jjmz/ula-vhdl/pics/Readme.md

Some pics :

The test/dev platform :

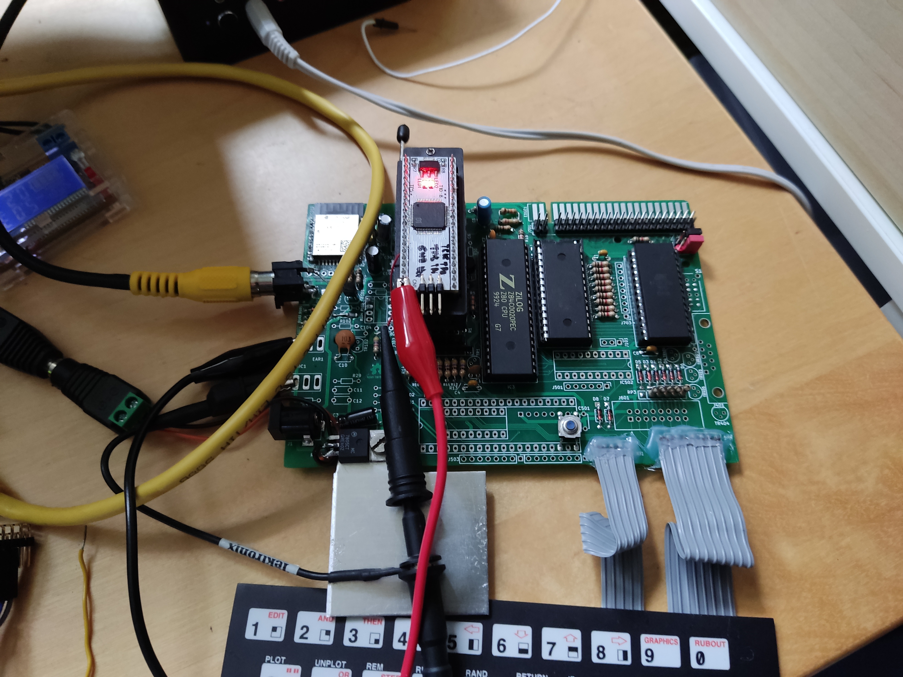
[picture p5: pics/IMG_20231112_103053.jpg]
devboard


Memory mapping with A13 connected :

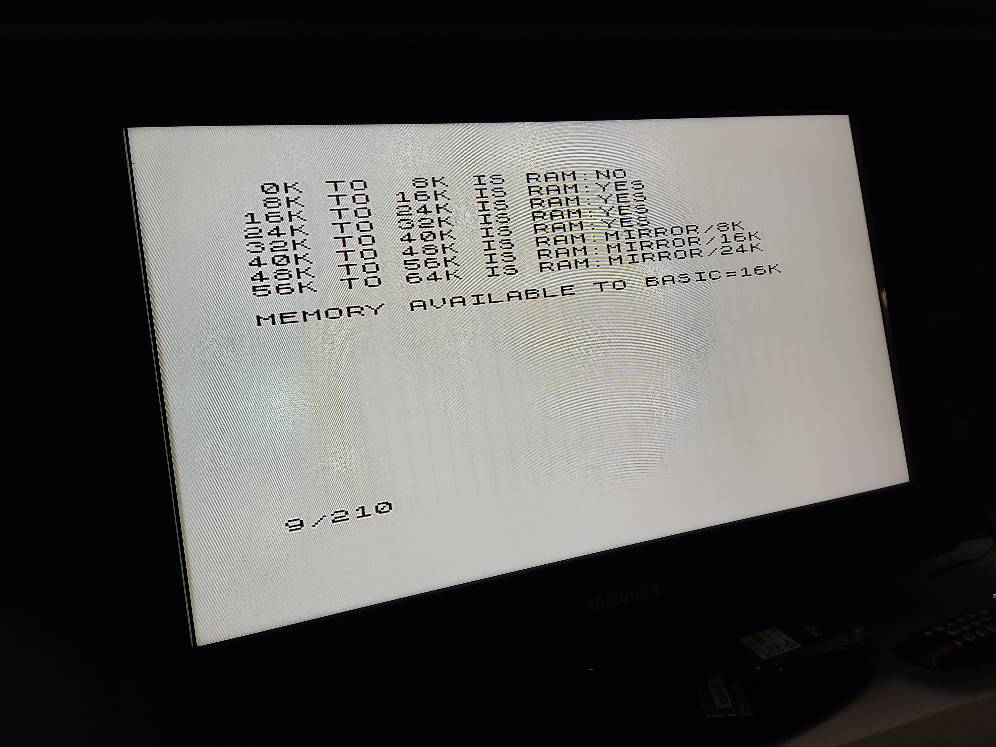
[picture p6: pics/IMG_20231107_162408.jpg]
memory1

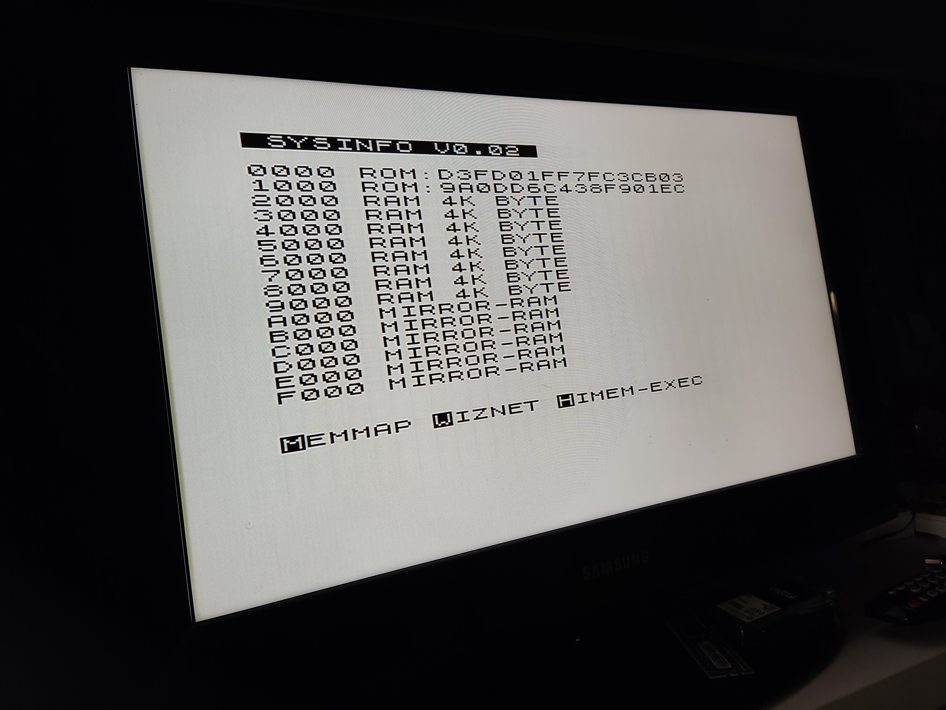
[picture p7: pics/IMG_20231107_162558.jpg]
memory2


Demo : 25thanni

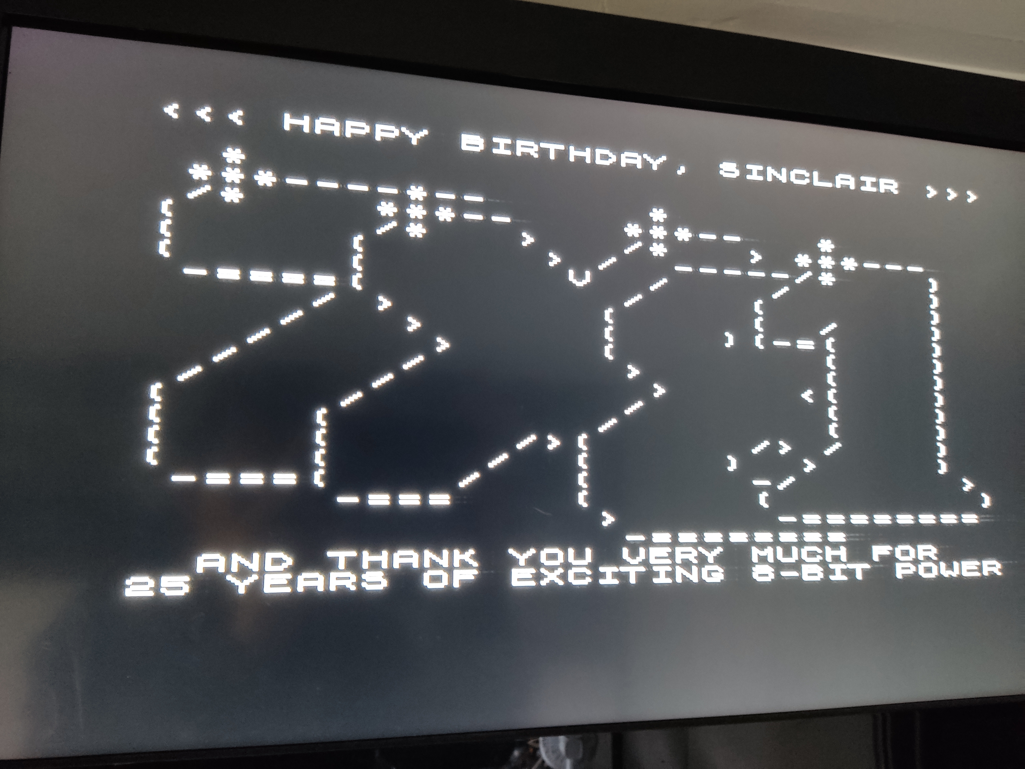
[picture p8: pics/IMG_20231112_103525.jpg]
demo1

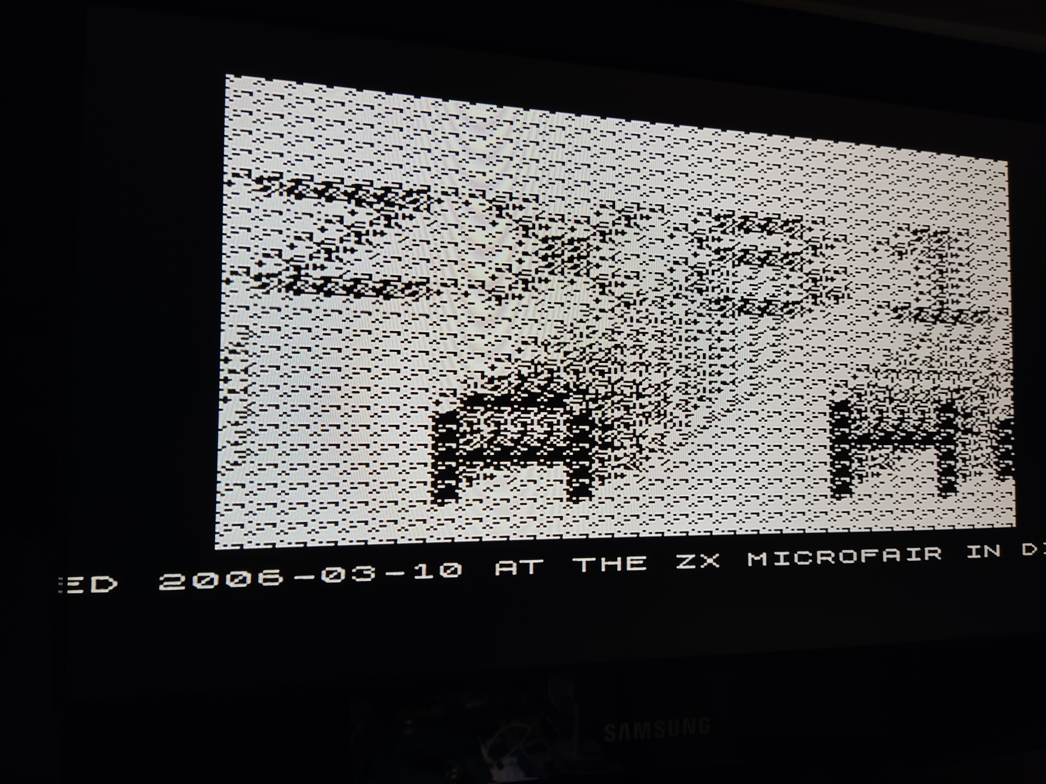
[picture p9: pics/IMG_20231112_103541.jpg]
demo2

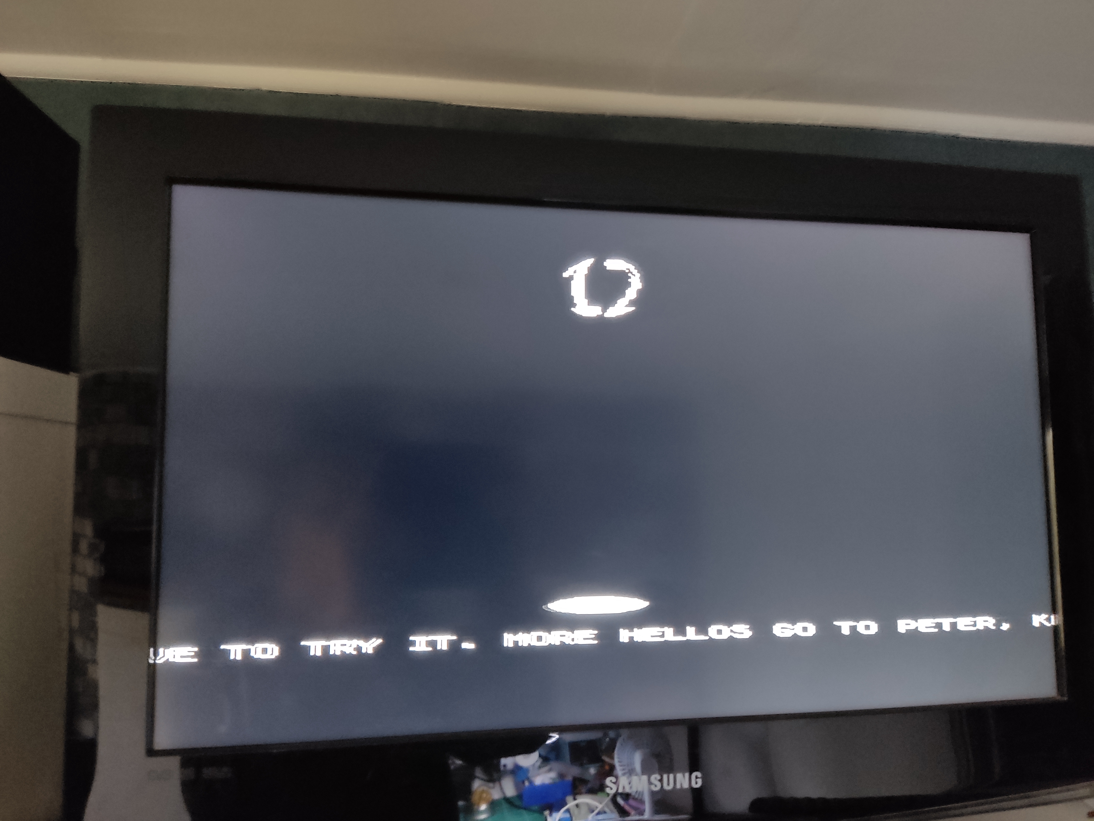
[picture p10: pics/IMG_20231112_103648.jpg]
demo3

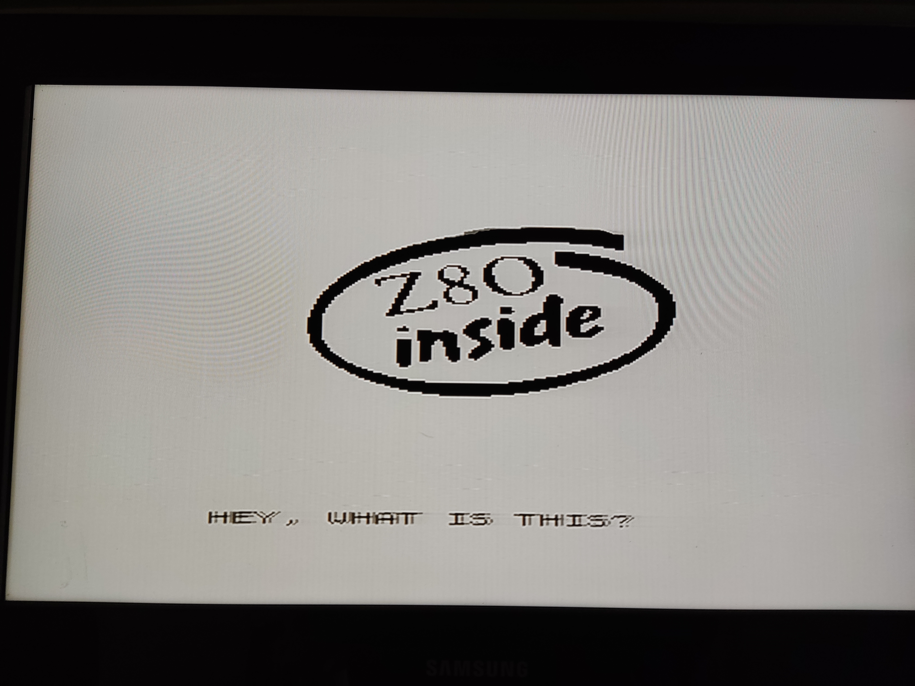
[picture p11: pics/IMG_20231112_103022.jpg]
demo4

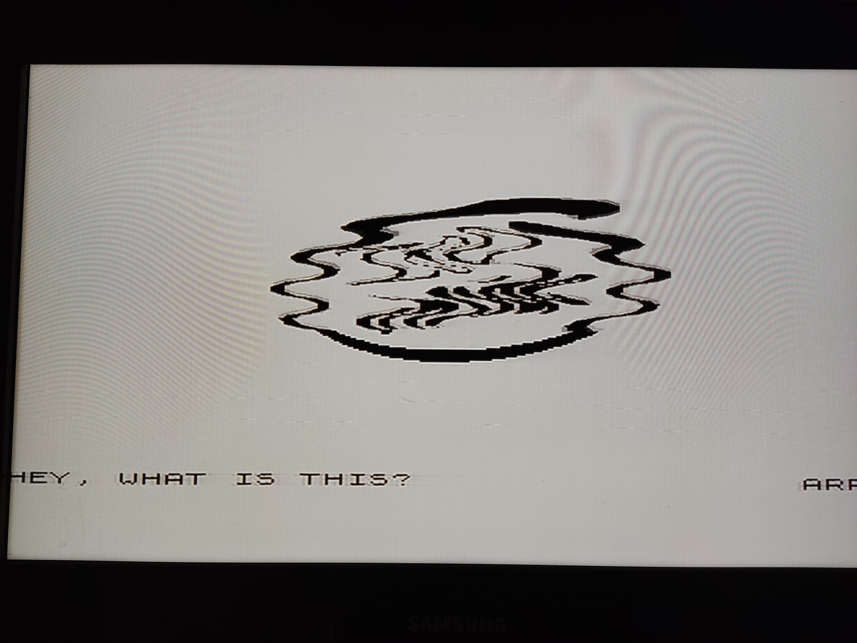
[picture p12: pics/IMG_20231112_103024.jpg]
demo5
