jjmz/ula-vhdl/pics/IMG_20231201_204323.jpg

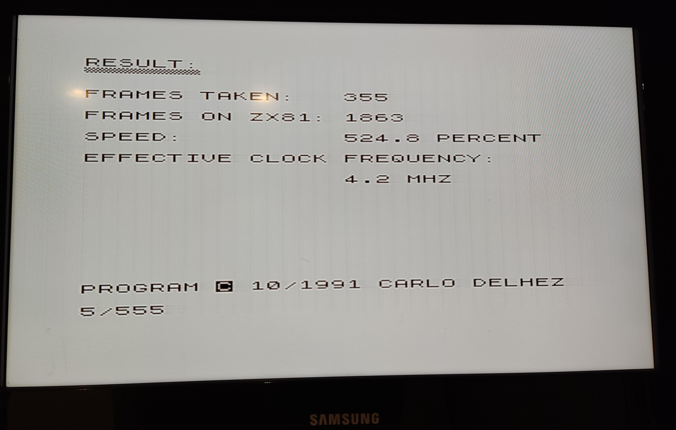
pics/IMG_20231201_204323.jpg
