jjmz/ula-vhdl/(threads)

Thread 1 (2022-11-20):

U3 and U5 in schematic

WellsWang, 2022-11-20:
Should U3 be 1117-3.3? provide a 3.3v power source?
Spec of U5 is 26Mhz active crystal oscillator？

Thanks.

jjmz, 2022-11-28:
Yes U3 is a 3.3 voltage regulator - 1117-3.3 is just fine.

U5 is a Crystal oscillator : ordered this one : https://fr.farnell.com/multicomp/mcsjk-6nc2-26-00-25-b/oscillateur-26mhz-7mm-x-5mm-cmos/dp/2854378

Closed 2022-11-28.

Thread 3 (2024-04-01):

smd components

jrweikle, 2024-04-01:
i can get the values of the Surface mount devices from the schematic
can you tell me what the sizes are ?

jjmz, 2024-04-03:
I have used 0805 smd.

Thread 4 (2024-09-01):

Crystal frecuency

ricardoblanche, 2024-09-01:
Hi, the crystal Is 13 or 6.5 MHz?

jjmz, 2024-09-04:
26mhz, see closed issue #1

Le 1 septembre 2024 04:11:37 GMT+02:00, ricardoblanche ***@***.***> a écrit :
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
--
Envoyé de mon appareil Android avec Courriel K-9 Mail. Veuillez excuser ma brièveté.

Closed 2024-09-04.
