jjmz/ula-vhdl/vhdl/addrgen.vhd

library ieee;
use ieee.std_logic_1164.all;
use ieee.std_logic_unsigned.all;

-- Library UNISIM;
-- use UNISIM.vcomponents.all;

entity addrgen is
    Port ( D        : in  STD_LOGIC_VECTOR (7 downto 0);
           LATCH_EN : in  STD_LOGIC;
           -- EN_OUT   : in  STD_LOGIC;

		     CLK :      in  STD_LOGIC;
           INCA :     in  STD_LOGIC;
           RSTA :     in  STD_LOGIC;

           Aout   : out  STD_LOGIC_VECTOR (8 downto 0);

           INV : out  STD_LOGIC);
end addrgen;

architecture Behavioral of addrgen is

signal LCNT: std_logic_vector(2 downto 0) :="000";
signal CHAR: std_logic_vector(7 downto 0);

begin

process (INCA, RSTA) 
begin
   if RSTA='1' then 
      LCNT <= (others => '0');
   elsif rising_edge(INCA) then
      LCNT <= LCNT + 1;
   end if;
end process;

process (CLK,LATCH_EN)
begin
 if rising_edge(CLK) then
  if LATCH_EN='1' then
   CHAR <= D;
  end if;
 end if;
end process;


Aout <= CHAR(5 downto 0)&LCNT;
INV  <= CHAR(7);

end Behavioral;
